almonds0166/608-final-project/site_report/images/ddr.jpg

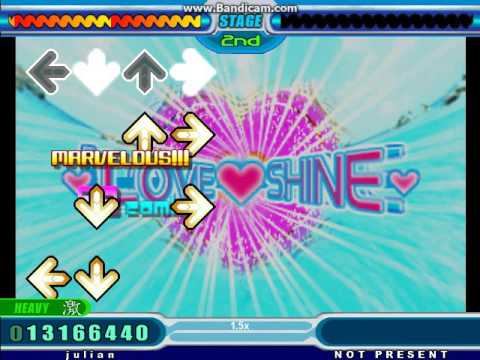
site_report/images/ddr.jpg
