almonds0166/608-final-project/site_report/images/script.png

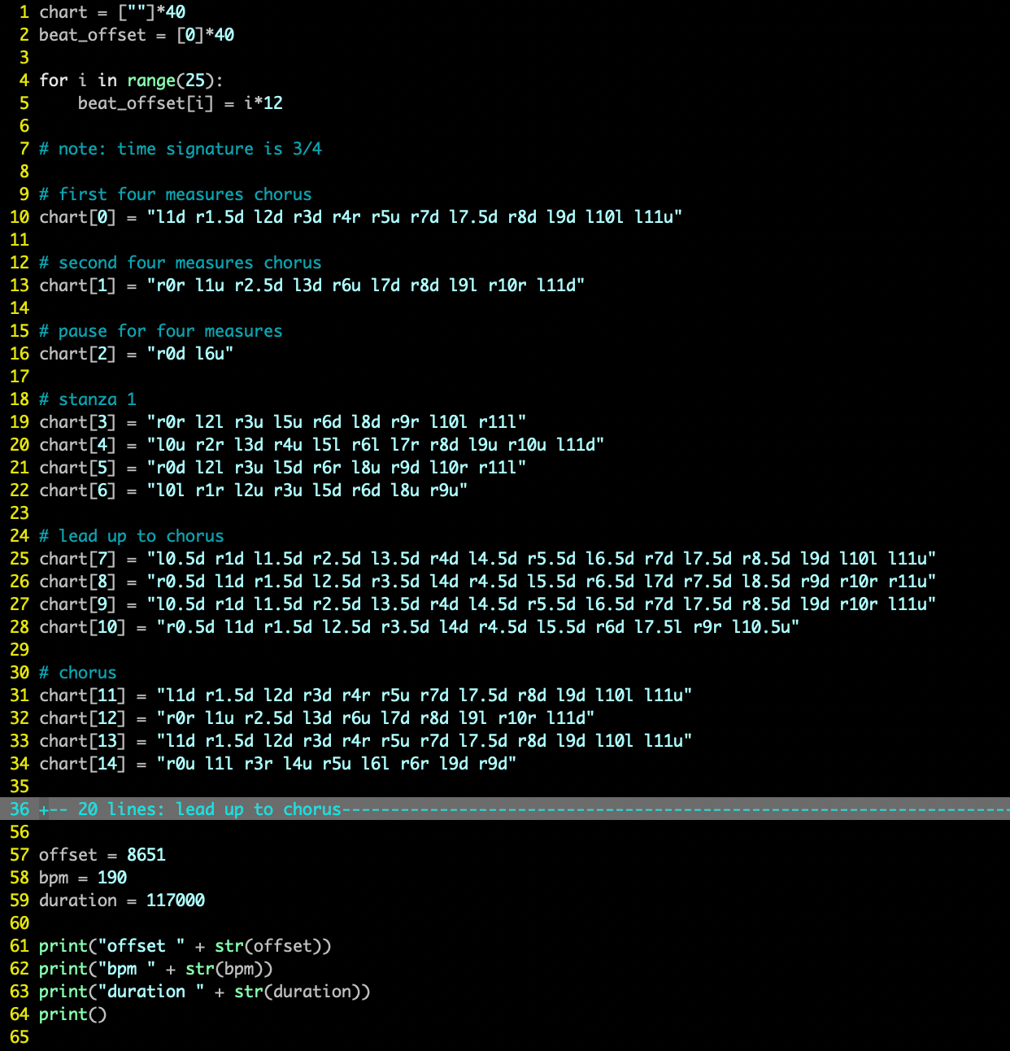
site_report/images/script.png
