almonds0166/608-final-project/BeatRevolution/Interface.h

#ifndef Interface_h
#define Interface_h
#include "Game.h"
#include "Button.h"

#define USERNAME_LENGTH_LIMIT 10
// NOTE: NUM_SONGS includes the initial null song, so it's actually equal to the number of real songs plus 1
#define NUM_SONGS 9
#define NUM_PLAYER_SCORES_TO_PULL 4

#define USERNAME_STATE 0
#define SONGSELECT_STATE 1
#define GAMEPLAY_STATE 2
#define SCORE_STATE 3

class Interface 
{
  private:

  Game* game;

  TFT_eSPI* screen;
  int cs_pin_left;
  int cs_pin_right;

  Button* button1;
  Button* button2;

  // set default colors
  const uint16_t BACKGROUND = TFT_BLACK;
  const uint16_t TEXT = TFT_WHITE;

  // set display size
  const uint8_t LEFT_EDGE = 0; //left side of screen limit
  const uint8_t RIGHT_EDGE = 127; //right side of screen limit
  const uint8_t TOP_EDGE = 0; //top of screen limit
  const uint8_t BOTTOM_EDGE = 159; //bottom of screen limit
  const uint8_t MIDDLE_WIDTH = RIGHT_EDGE/2;
  const uint8_t MIDDLE_HEIGHT = BOTTOM_EDGE/2;

  // Used for the finer details
  const uint8_t CHAR_WIDTH  = 6;
  const uint8_t FIRST_QTR = MIDDLE_WIDTH / 2;
  const uint8_t LAST_QTR = MIDDLE_WIDTH + FIRST_QTR;
  const uint16_t FADE[7] = {
    0x4208,
    0x6B4D,
    0xC618,
    TFT_WHITE,
    0xC618,
    0x6B4D,
    0x4208 }; // http://www.barth-dev.de/online/rgb565-color-picker/

  int state; // state of the interface (username, song selection, score display)

  // variables for username selection
  char alphabet[50] = " ABCDEFGHIJKLMNOPQRSTUVWXYZ0123456789";
  char username[USERNAME_LENGTH_LIMIT+1] = {0}; 

  char** song_list;
  int song_index;

  char high_scores[NUM_SONGS][NUM_PLAYER_SCORES_TO_PULL][2][10]; 
  // pull high scores at the beginning of game
  // 2 fields, username and score
  // up to 10 characters for each field

  void select_username(); // handles selecting a username
  void display_warning(char* warning_message);
  void clear_warning();
  boolean update_song_index(int flag1, int flag2);
  void update_song_display();
  void display_high_scores();
  void get_high_scores(int index);
  void display_play_data();
  void upload_score(uint32_t score); // upload score, probably want to take score and maybe song name or username as params
  void clear_screens();

  public:

  Interface(Game* game_pointer, TFT_eSPI* tft, int tft_pin_left, int tft_pin_right, Button* button1_pointer, Button* button2_pointer, char** songs);
  void process(); // handles state changes
  void get_all_high_scores();
};

#endif
