almonds0166/608-final-project/(commit log)

2019-04-19 messed around with declaring fields in c++, current version no longer has compiler errors
    [BeatRevolution.ino, Display.h, Game.cpp, Game.h]
2019-04-21 version now works with display and motion detection, do not remove lines marked by NOTE as they fix a memory heisenbug
    [BeatRevolution.ino, Saber.cpp, Saber.h]
2019-04-24 load displays with correct bpm and offset
    [Display.cpp, Game.cpp]
2019-04-24 fixed bug due to misunderstanding of timestamps between display and game loader
    [Display.cpp, Game.cpp, Game.h]
2019-04-25 fixed small bug with score initialization
    [Game.cpp]
2019-04-26 trying to incorporate two imus, doesn't quite work but getting there
    [BeatRevolution.ino, Game.cpp, Saber.cpp, Saber.h]
2019-04-26 now works with two imus, uses different library and wiring from before
2019-04-27 moved a couple declarations around, changed parameters of interface
2019-04-27 added wiring guide
2019-04-29 added interface skeleton and specs, fixed bugs
    [BeatRevolution.ino, Game.h, Interface.cpp, Interface.h]
2019-04-29 Update table.html
    Updated CSS and radio buttons
2019-04-29 syntax errors fixes, oops
    [Game.cpp, Game.h, Interface.cpp, Interface.h]
2019-04-30 added classy button class
2019-04-30 updated button to handle long update periods
2019-04-30 fixed interface, everything now works
    [BeatRevolution.ino, Button.cpp, Game.cpp, Game.h, Interface.cpp, Interface.h]
2019-04-30 added mechanism to avoiding completely dying when wifi disconnects
    [Game.cpp, Game.h, Interface.cpp]
2019-05-02 a variety of bug fixes, communication with server now works, playing more songs after the first song is no longer broken
    [Button.cpp, Button.h, Display.cpp, Game.cpp, Game.h, Interface.cpp, Saber.cpp, Saber.h]
2019-05-03 improved IMU sampling rate, changed motion detection again slightly
2019-05-03 added combo and perfect vs decent notes note that combo and score together are too long to be displayed in one line, unless we remove the words or something
    [BeatRevolution.ino, Display.cpp, Display.h, Game.cpp, Game.h, Interface.cpp, Interface.h, Saber.cpp]
2019-05-05 Added ability to switch between userane, song selection, and gameplay states. Refuses empty username. Shows warning message for empty and too long usernames.
    [Game.cpp, Game.h, Interface.cpp]
2019-05-08 Update scoreboard.py
    Only return at most 5 scores to the ESP32
2019-05-08 Update Interface.h
    Added a constant to help with pretty printing later
2019-05-08 Update Interface.h
    Constants for pretty printing song selection
2019-05-08 Update Interface.cpp
    Added hacky fix for Bloody Purity
    [Interface.cpp]
2019-05-08 Update Interface.cpp
    Now prints username on song selection screen
2019-05-08 Update Interface.cpp
    Prevented warning messages from writing over the displayed username
    [Interface.cpp]
2019-05-13 added interface and button classes to site report
2019-05-15 digging deeeeep into the MPU library code now relies on fast versions of functions (such as begin, calibrate, etc) that are edited versions of the originals doesn't solve the problem of broken IMU re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
    [BeatRevolution.ino, Game.cpp, Game.h, Interface.cpp, Saber.cpp, Saber.h]
2019-05-15 imu documentation
2019-05-15 updated imu state machine
2019-05-15 patching over the problem, IMUs get restarted whenever readings appear stale
    [Saber.cpp]
2019-05-17 fixed another score related bug
    [BeatRevolution.ino, Interface.cpp, Interface.h]
2019-05-17 finally actually fixed score overflow bug
    [Interface.cpp, Saber.cpp]
2019-05-17 Update BeatRevolution.md.html
    Added Power Consumption section
